lelochplus/VMS/docs/layout_1_floorplan.png

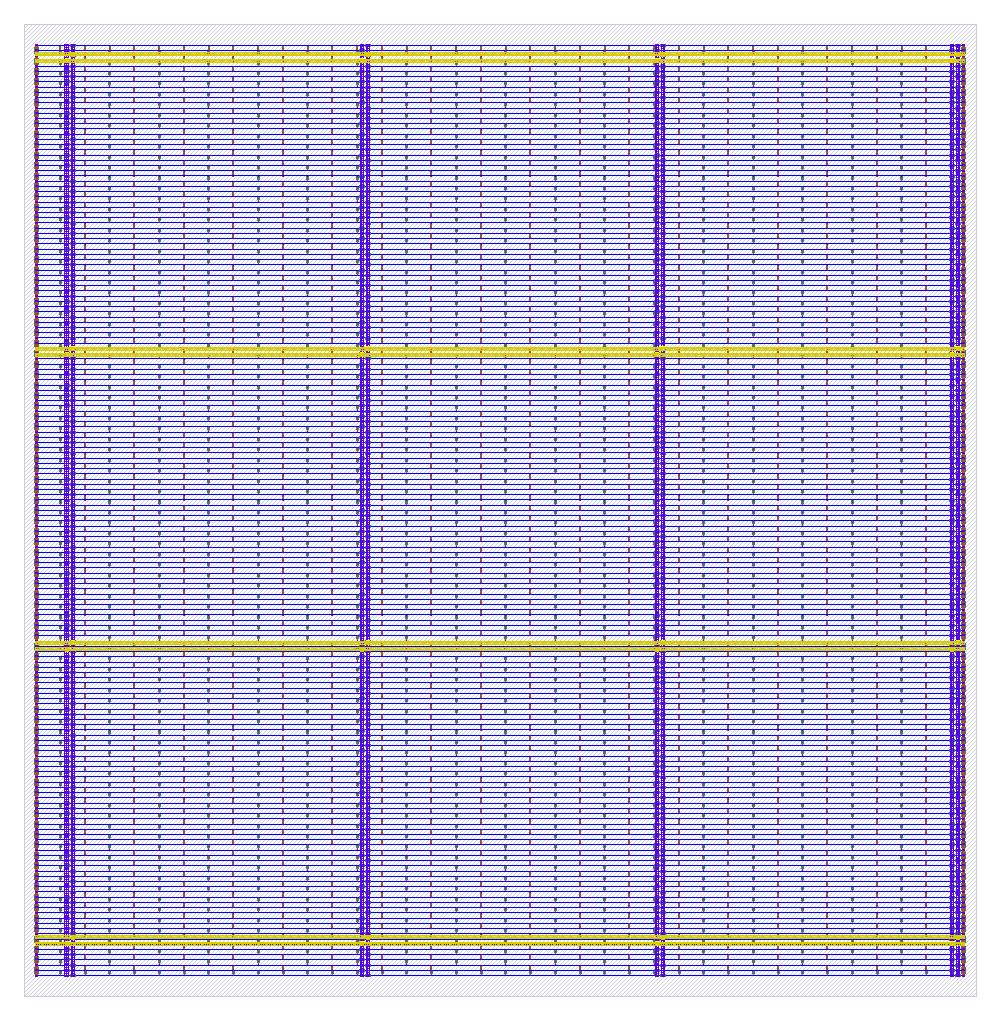
docs/layout_1_floorplan.png
