lelochplus/VMS/docs/layout_2_placement.png

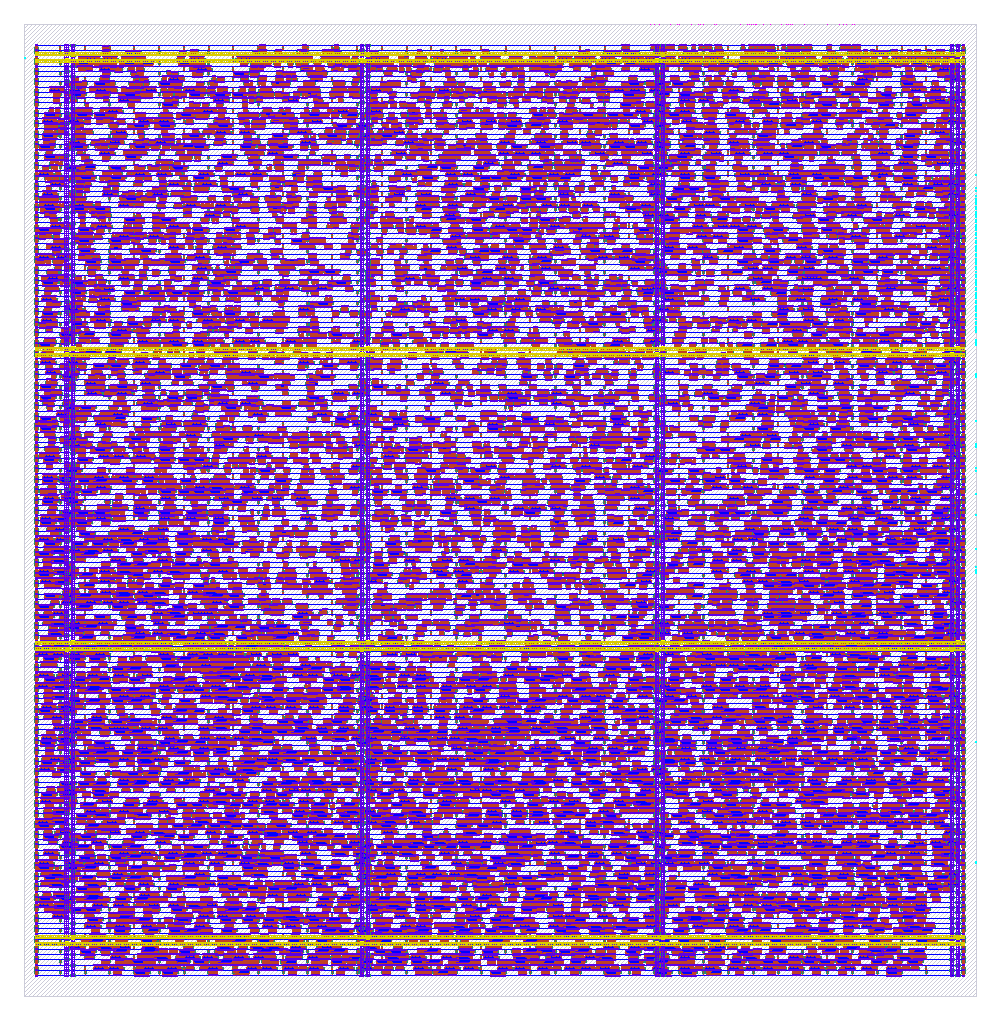
docs/layout_2_placement.png
