lelochplus/VMS/docs/layout_3_cts.png

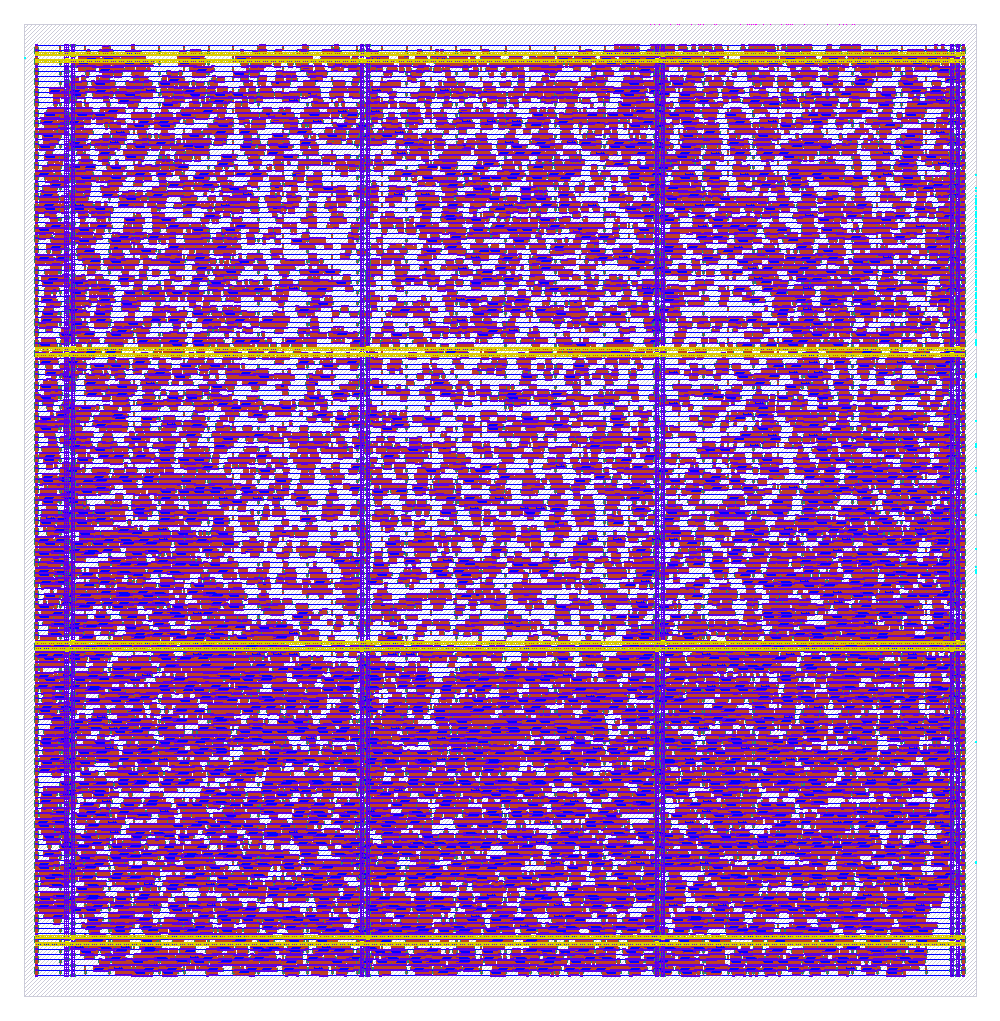
docs/layout_3_cts.png
