lelochplus/VMS/docs/layout_4_routing.png

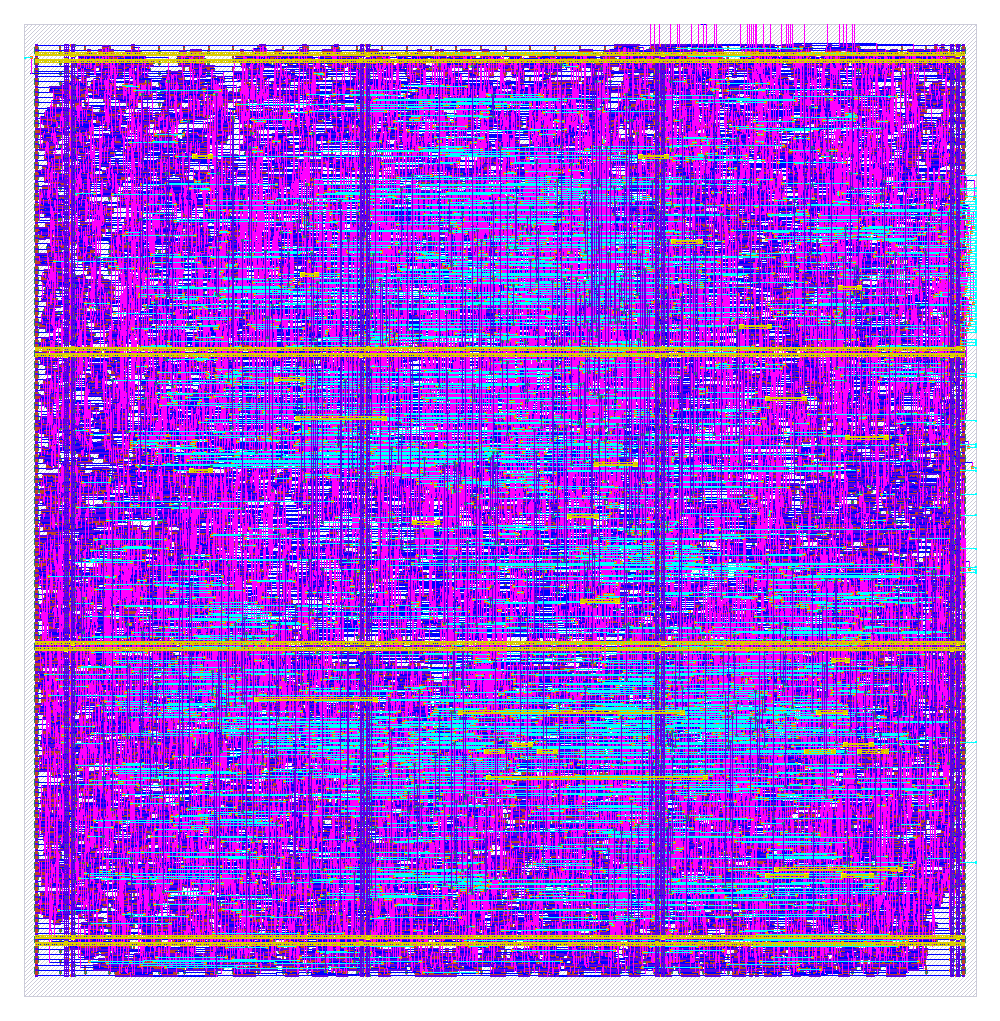
docs/layout_4_routing.png
