lelochplus/VMS/docs/layout_5_final.png

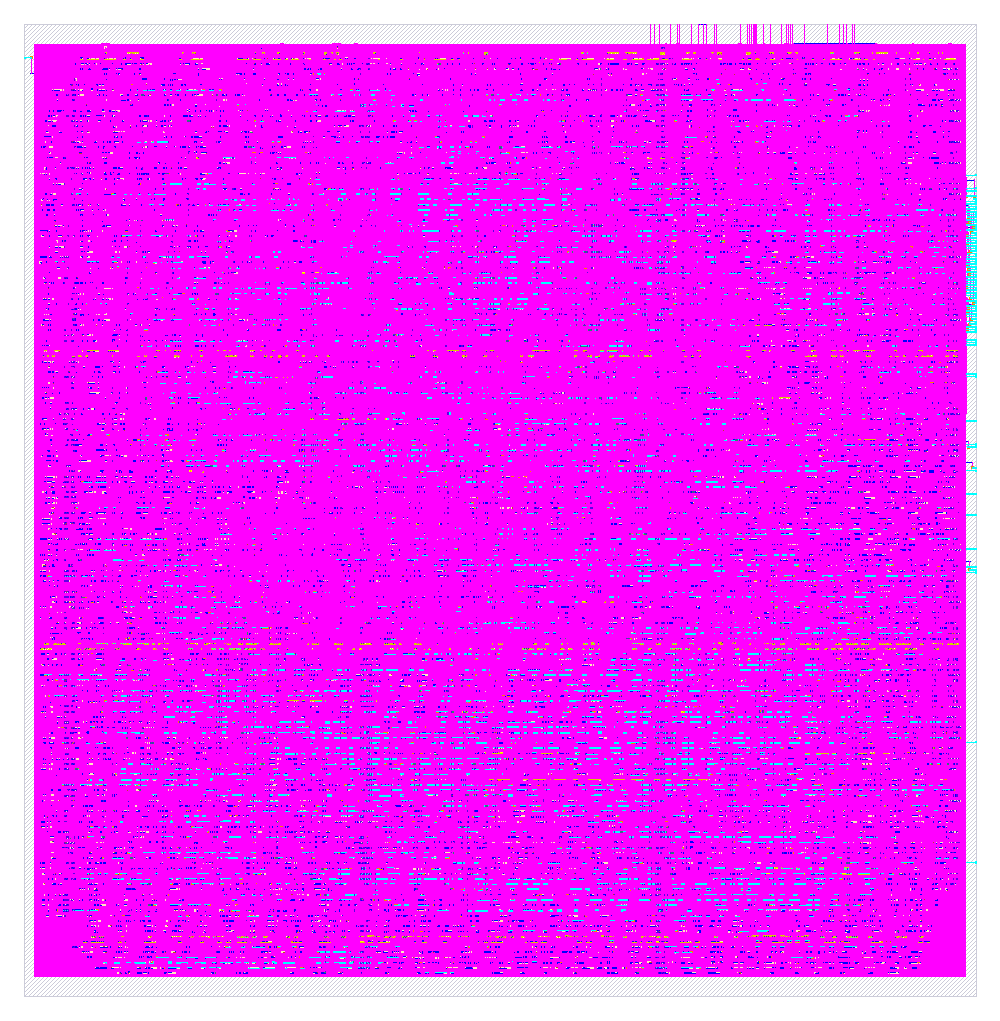
docs/layout_5_final.png
