lelochplus/VMS/docs/layout_dma_ctrl.png

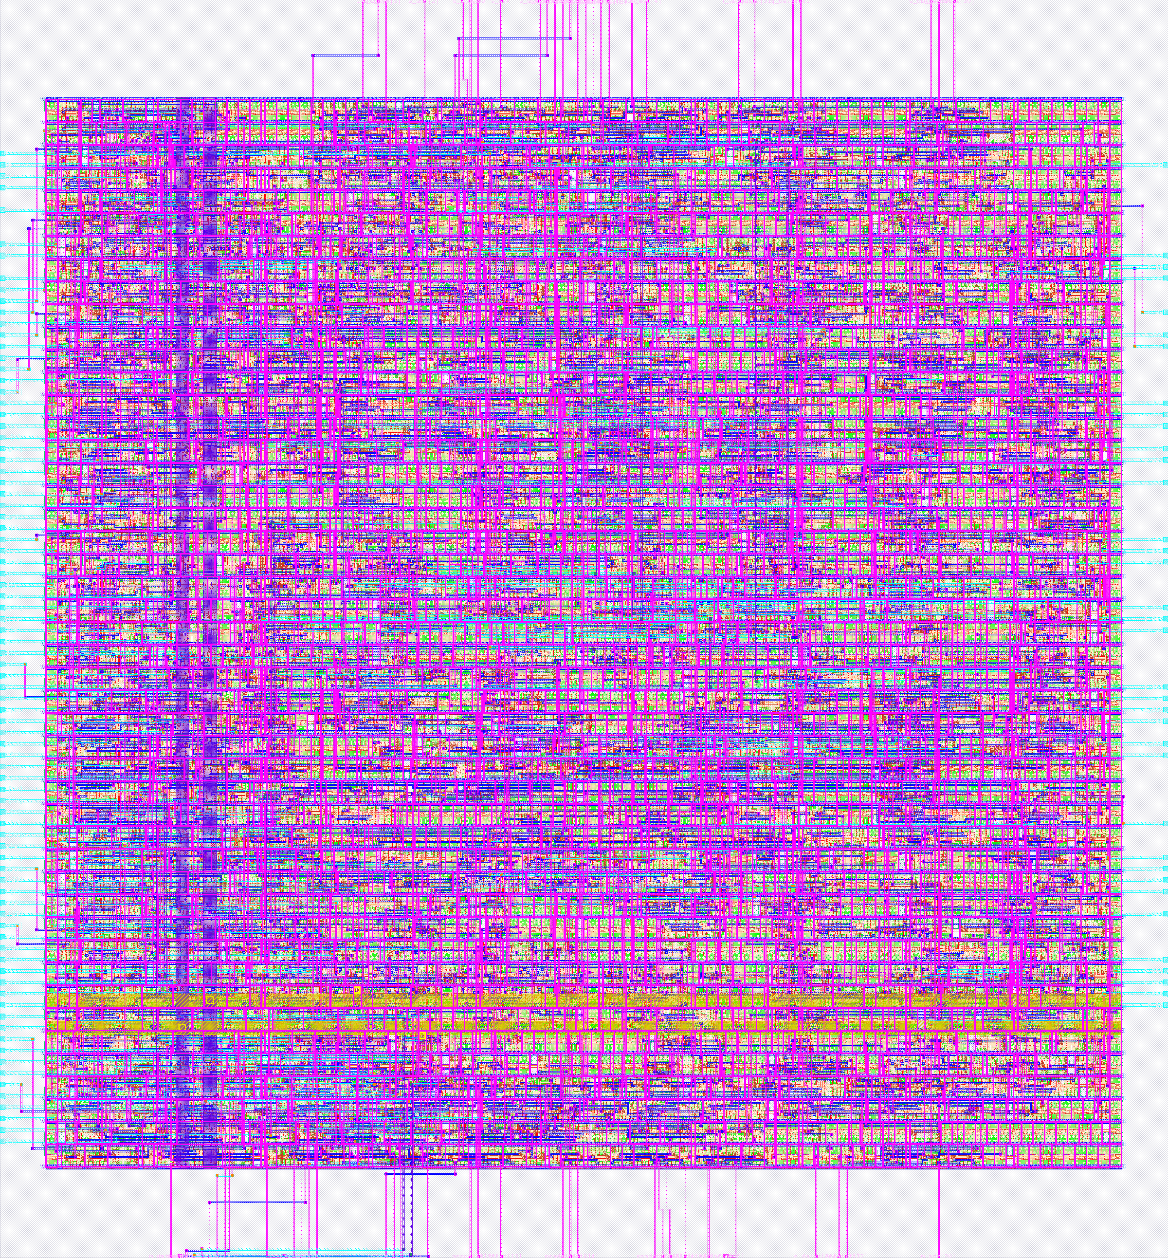
docs/layout_dma_ctrl.png
