lelochplus/VMS/docs/layout_soc_core.png

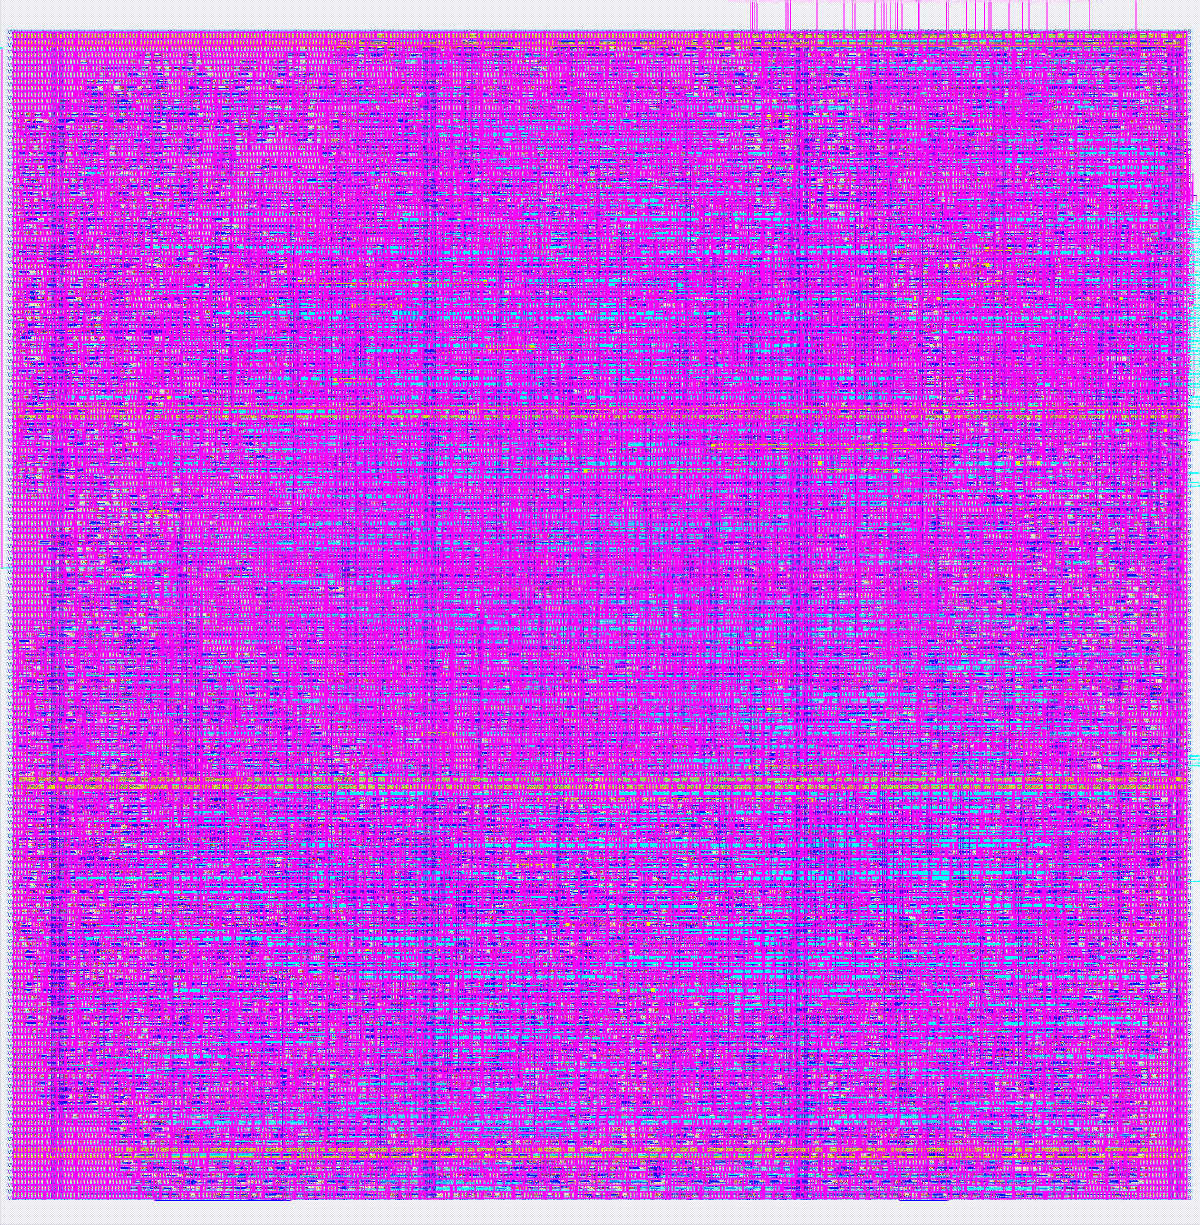
docs/layout_soc_core.png
