lelochplus/VMS/docs/layout_soc_core_zoom.png

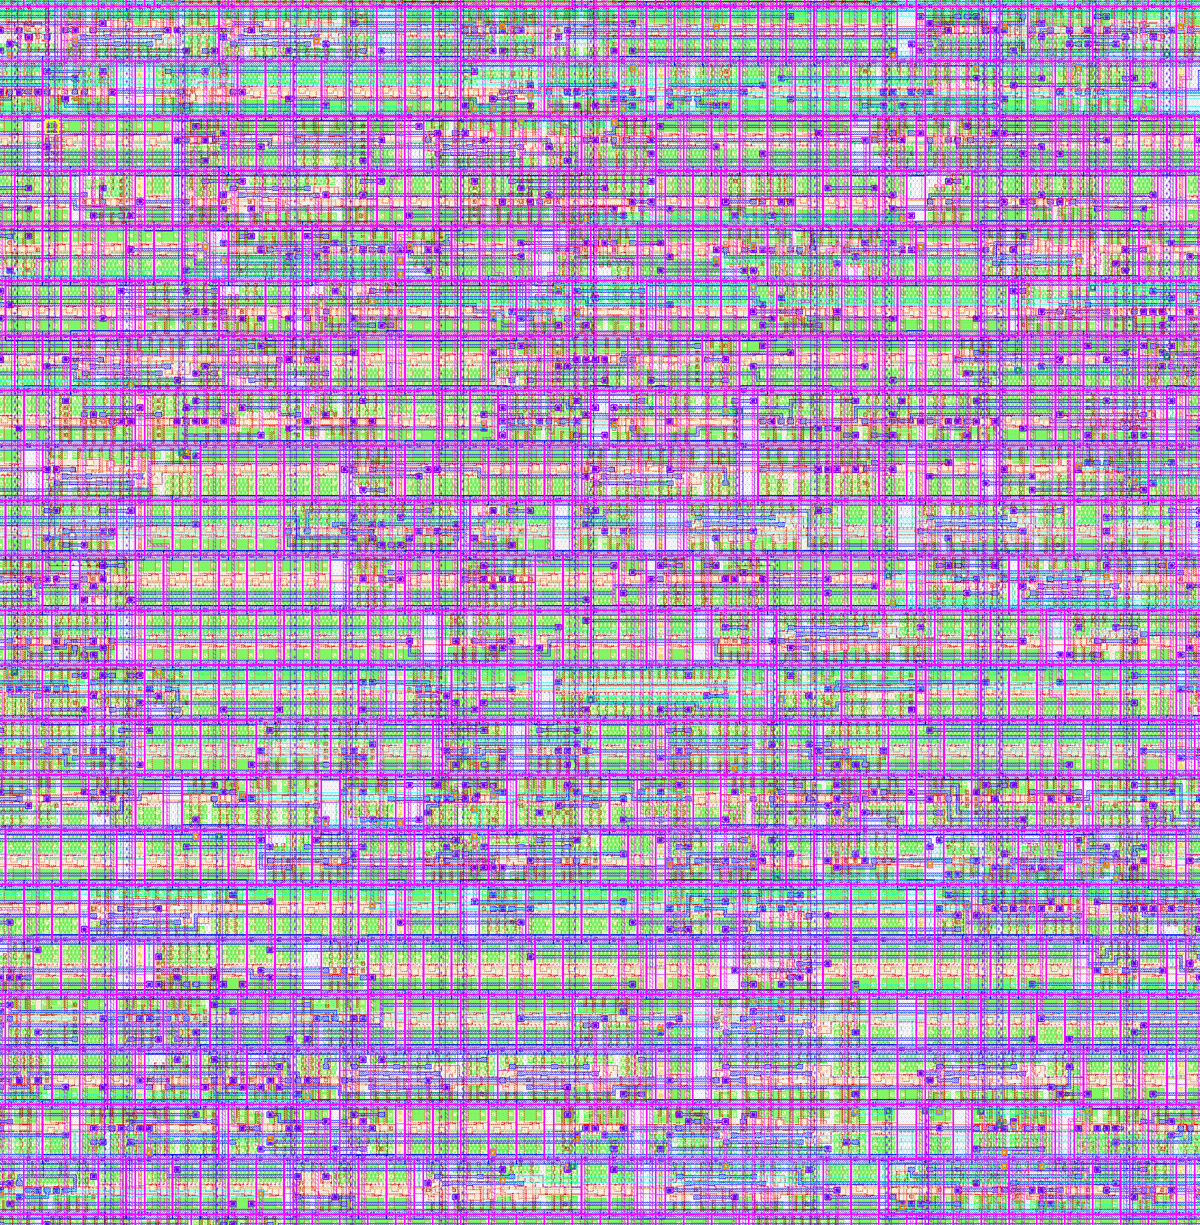
docs/layout_soc_core_zoom.png
