lelochplus/VMS/tb/tb_soc.v

`timescale 1ns/1ps
module tb_soc;
    reg clk = 0;
    reg rst = 1;
    always #10 clk = ~clk;                       // 50 MHz

    parameter  CLK_DIV = 16;                     // UART nhanh để mô phỏng ngắn

    wire uart_tx, trap;

    soc_top #(.RAM_WORDS(2048), .CLK_DIV(CLK_DIV), .FW_HEX("sw/fw")) dut (
        .clk(clk), .rst(rst), .uart_tx(uart_tx), .trap(trap)
    );

    // Chuỗi mong đợi (33 ký tự), firmware kết thúc bằng byte 0x04 (EOT)
    localparam NEXP = 41;
    localparam [8*NEXP-1:0] EXPECT = "Hello, RISC-V SoC!\nDMA OK\nIRQ OK\nCONC OK\n";
    integer n = 0;
    integer bad = 0;
    integer i;
    reg [7:0] ch;

    // Đo thời gian BUSY của DMA (chu kỳ clk), giữ giá trị của lần chép gần nhất
    integer cyc = 0, busy_t0 = 0, busy_cycles = 0;
    always @(posedge clk) cyc <= cyc + 1;
`ifndef GL   // netlist đã làm phẳng: không dò được tín hiệu bên trong
    always @(posedge dut.core.dma.busy) busy_t0 = cyc;
    always @(negedge dut.core.dma.busy) if (!rst) busy_cycles = cyc - busy_t0;
`endif

    // Giao dịch RAM hoàn tất trong lúc DMA BUSY, tách theo master: CPU phải không bị khóa bus
    integer ram_cpu = 0, ram_dma = 0;
`ifndef GL
    always @(posedge clk) if (!rst && dut.core.dma.busy && dut.core.ram_ack) begin
        if (dut.core.use_dma) ram_dma <= ram_dma + 1;
        else                  ram_cpu <= ram_cpu + 1;
    end
`endif

    // Mỗi lần DMA chạy: số chu kỳ BUSY và độ trễ từ lúc BUSY lên đến giao dịch RAM đầu tiên của DMA
    reg busy_d = 0, first = 0;
    integer nrun = 0, t_start = 0, k;
    integer run_busy [0:15];
    integer run_lat  [0:15];
`ifndef GL
    always @(posedge clk) if (!rst) begin
        busy_d <= dut.core.dma.busy;
        if (dut.core.dma.busy && !busy_d) begin t_start <= cyc; first <= 1; end
        if (first && dut.core.ram_ack && dut.core.use_dma) begin run_lat[nrun] <= cyc - t_start; first <= 0; end
        if (!dut.core.dma.busy && busy_d) begin run_busy[nrun] <= cyc - t_start; nrun <= nrun + 1; end
    end
`endif

    // Giải mã UART 8N1 rồi in ký tự ra console
    initial begin
        forever begin
            @(negedge uart_tx);                              // bit start
            repeat (CLK_DIV + CLK_DIV/2) @(posedge clk);     // giữa bit d0
            for (i = 0; i < 8; i = i + 1) begin
                ch[i] = uart_tx;
                repeat (CLK_DIV) @(posedge clk);
            end
            if (ch == 8'h04) begin
                if (n >= NEXP && bad == 0 && ram_cpu > 0 && ram_dma > 0) $display("PASS: SoC va DMA hoat dong dung");
                else                       $display("FAIL: nhan %0d ky tu, %0d ky tu sai", n, bad);
                $display("DMA busy (lan chep cuoi): %0d chu ky", busy_cycles);
                for (k = 0; k < nrun; k = k + 1)
                    $display("[tb] DMA lan %0d: BUSY %0d chu ky, tre khoi dong %0d chu ky", k + 1, run_busy[k], run_lat[k]);
                $display("Trong luc DMA BUSY: CPU %0d, DMA %0d giao dich RAM", ram_cpu, ram_dma);
                $finish;
            end else begin
                $write("%c", ch);
                if (n < NEXP && ch !== EXPECT[8*(NEXP-1-n) +: 8]) bad = bad + 1;
                n = n + 1;
`ifdef GL
                if (n == NEXP) begin
                    if (bad == 0) $display("\nPASS: netlist sau tong hop chay dung firmware");
                    else          $display("\nFAIL: %0d ky tu sai", bad);
                    $finish;
                end
`endif
            end
        end
    end

    always @(posedge clk) if (trap) begin
        $display("FAIL: CPU bao trap");
        $finish;
    end

    initial begin
`ifndef GL
        $dumpfile("soc.vcd");
        $dumpvars(0, tb_soc);
`endif
        repeat (8) @(posedge clk);
        #1 rst = 0;
    end

    initial begin
        #20_000_000;
        $display("FAIL: watchdog het thoi gian");
        $finish;
    end
endmodule
