lelochplus/VMS/(commit log)

2026-10-27 RISC-V SoC + DMA: RTL, testbench, firmware, LibreLane
2026-10-27 DMA: khoa CTRL khi BUSY; them T10, T11; make lint
2026-10-28 p5c: test CPU va DMA dung bus dong thoi
2026-10-28 p8d: ban NO_DMA de so tai nguyen FPGA/ASIC
2026-10-28 README: FPGA, do N=16..256, tai nguyen co/khong DMA
2026-10-28 README: ASIC co/khong DMA; config thu sua slew
2026-10-28 README: fix3 la ket qua ASIC chinh
2026-10-28 flow: danh gia giai doan 1 (tong hop), 2 (floorplan + PDN)
2026-10-28 flow: danh gia giai doan 3 (placement)
2026-10-28 flow: danh gia giai doan 4 (CTS)
2026-10-28 flow: danh gia giai doan 5 (routing)
2026-10-28 flow: danh gia giai doan 6 (signoff), tong hop docs/flow/README.md
2026-10-28 flow: sua dinh dang so, lien ket tu README
2026-10-28 flow: thoi gian chay tung giai doan, anh layout KLayout
2026-10-28 flow: dau phay thap phan
2026-11-03 Them firmware hex va file SDC de chay tren Gowin EDA
